s163555/sensor_pcb/README.md

# Sensor\_AFE\_PCB

* [PCB source](https://github.com/adafruit/Adafruit-MAX31865-PCB)
* [Wiki](https://learn.adafruit.com/adafruit-max31865-rtd-pt100-amplifier)
