s163555/sensor_pcb/Figure_2.png

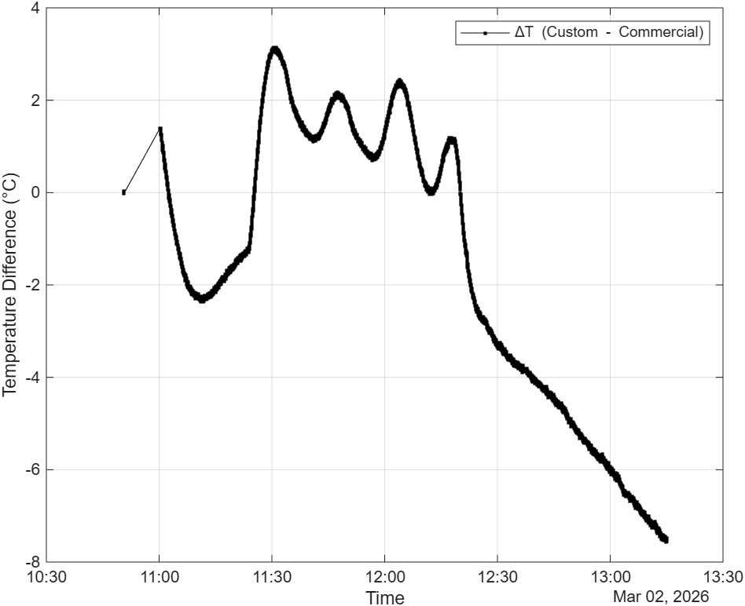
Figure_2.png
