s163555/sensor_pcb/wire_bond_holder2.stl

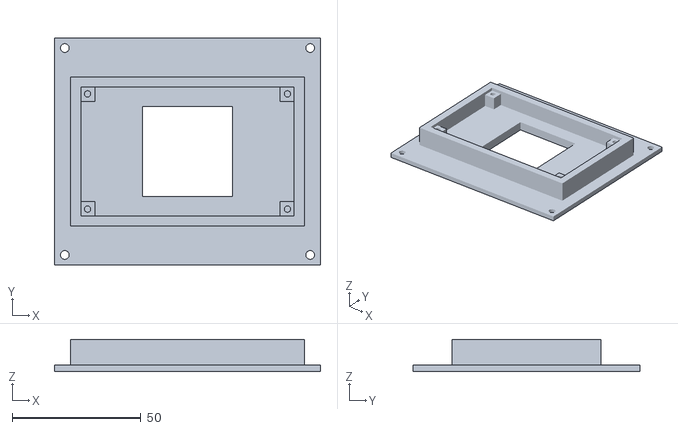
[picture p9: CAD file, 2026-03-02]
wire_bond_holder2.stl
103.5 x 88.5 x 12.5
