s163555/sensor_pcb/sensor_pcb.kicad_pcb

## KiCad design sensor_pcb.kicad_pcb (2025-10-31)

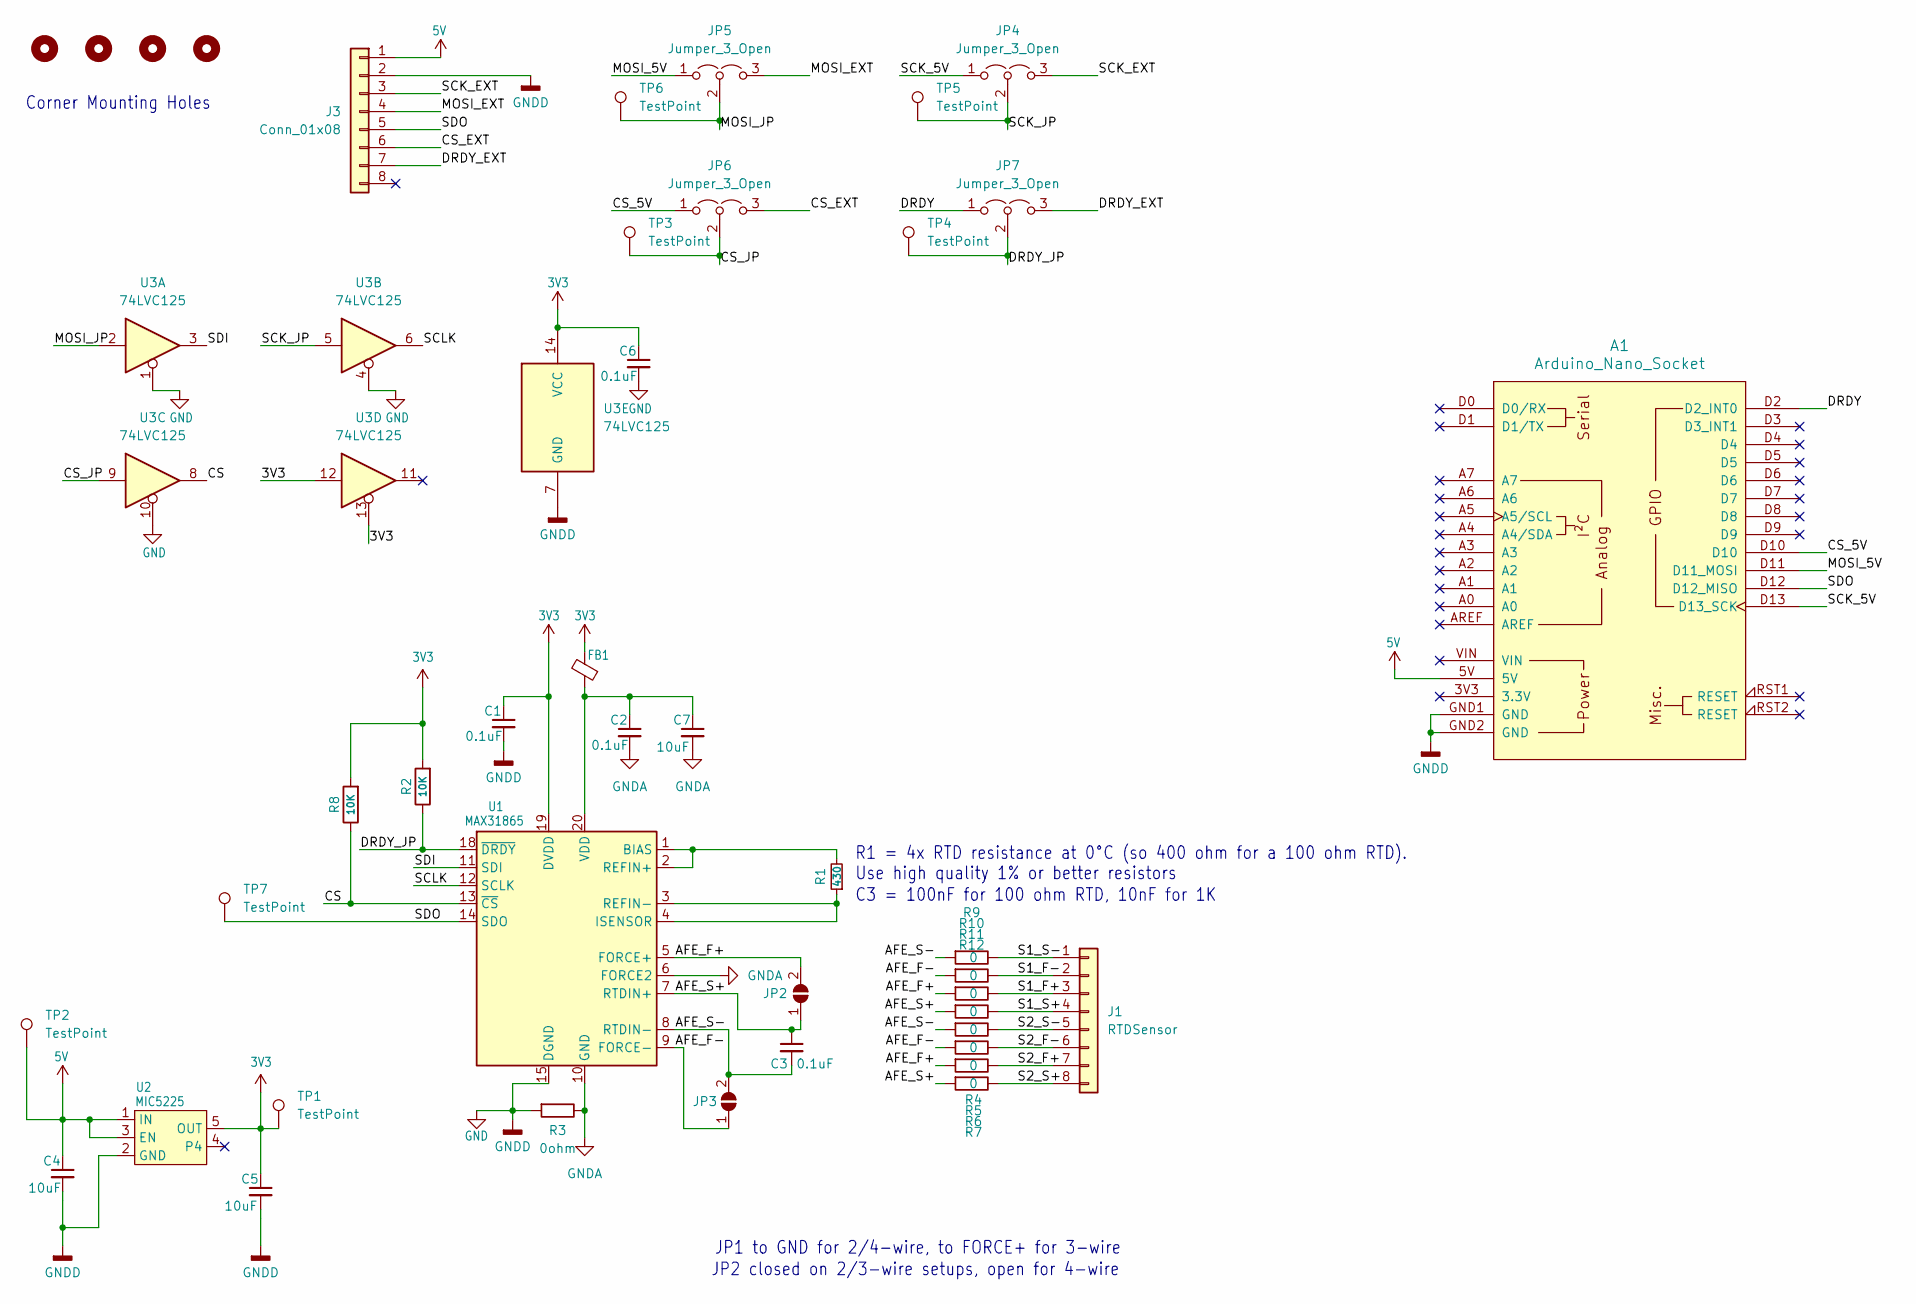
[picture p10: schematic sensor_pcb.kicad_sch, RTD Sensor PCB]

Parts:
A1: Arduino_Nano_Socket
C1, C2, C3, C6: 0.1uF; C_0805_2012Metric; MPN /
C4, C5, C7: 10uF; C_0805_2012Metric; MPN /
FB1: FERRITE-0805NO; LI0805G201R-10; MPN LI0805G201R-10
J1: RTDSensor; RTD_Sensor_BondPad_interdigitated
J3: Conn_01x08; Molex_KK-254_AE-6410-08A_1x08_P2.54mm_Vertical
JP2, JP3: SOLDERJUMPER; SolderJumper-2_P1.3mm_Open_RoundedPad1.0x1.5mm
JP4, JP5, JP6, JP7: Jumper_3_Open; PinHeader_1x03_P2.54mm_Vertical
R1: 430; R_0805_2012Metric; Tolerance Plus-Minus 0.1%; MPN /
R2, R8: 10K; R_0805_2012Metric; MPN /
R3: 0ohm; R_0805_2012Metric
R4, R5, R6, R7, R9, R10, R11, R12: 0; R_0805_2012Metric
TP1, TP2, TP3, TP4, TP5, TP6, TP7: TestPoint; TestPoint_Pad_D1.0mm
U1: MAX31865; MAX31865ATP+; MPN MAX31865ATP+
U2: MIC5225; MPN MIC5225-3.3YM5-TR
U3: 74LVC125
U$1, U$2, U$18, U$19: MOUNTINGHOLE2.5; MountingHole_2.2mm_M2_ISO7380

Connections:
3V3: C1.1, C5.1, C6.1, FB1.2, R2.2, R8.2, TP1.1, U1.19 (DVDD), U2.5 (OUT), U3.12, U3.13, U3.14 (VCC)
5V: A1.5V, C4.1, J3.1, TP2.1, U2.1 (IN), U2.3 (EN)
/AFE_F+: JP2.2 (B), R6.1, R11.1, U1.5 (FORCE+)
/AFE_F-: JP3.1 (A), R5.1, R10.1, U1.9 (FORCE-)
/AFE_S+: C3.1, JP2.1 (A), R7.1, R12.1, U1.7 (RTDIN+)
/AFE_S-: C3.2, JP3.2 (B), R4.1, R9.1, U1.8 (RTDIN-)
/CS: R8.1, U1.13 (~CS), U3.8
/CS_5V: A1.D10, JP6.1 (A)
/CS_EXT: J3.6, JP6.3 (B)
/CS_JP: JP6.2 (C), TP3.1, U3.9
/DRDY: A1.D2 (D2_INT0), JP7.1 (A)
/DRDY_EXT: J3.7, JP7.3 (B)
/DRDY_JP: JP7.2 (C), R2.1, TP4.1, U1.18 (~DRDY)
/MOSI_5V: A1.D11 (D11_MOSI), JP5.1 (A)
/MOSI_EXT: J3.4, JP5.3 (B)
/MOSI_JP: JP5.2 (C), TP6.1, U3.2
/S1_F+: J1.3, R11.2
/S1_F-: J1.2, R10.2
/S1_S+: J1.4, R12.2
/S1_S-: J1.1, R9.2
/S2_F+: J1.7, R6.2
/S2_F-: J1.6, R5.2
/S2_S+: J1.8, R7.2
/S2_S-: J1.5, R4.2
/SCK_5V: A1.D13 (D13_SCK), JP4.1 (A)
/SCK_EXT: J3.3, JP4.3 (B)
/SCK_JP: JP4.2 (C), TP5.1, U3.5
/SCLK: U1.12 (SCLK), U3.6
/SDI: U1.11 (SDI), U3.3
/SDO: A1.D12 (D12_MISO), J3.5, TP7.1, U1.14 (SDO)
GND: A1.GND1 (GND), A1.GND2 (GND), C1.2, C4.2, C5.2, C6.2, J3.2, R3.1, U1.15 (DGND), U2.2 (GND), U3.1, U3.4, U3.7 (GND), U3.10
GNDA: C2.2, C7.2, R3.2, U1.6 (FORCE2), U1.10 (GND), U1.16 (GND), U1.21 (GND)
unnamed: R1.2, U1.1 (BIAS), U1.2 (REFIN+)
unnamed: R1.1, U1.3 (REFIN-), U1.4 (ISENSOR)
unnamed: C2.1, C7.1, FB1.1, U1.20 (VDD)

Notes on the sheet:
JP1 to GND for 2/4-wire, to FORCE+ for 3-wire
R1 = 4x RTD resistance at 0°C (so 400 ohm for a 100 ohm RTD). Use high quality 1% or better resistors
Corner Mounting Holes
C3 = 100nF for 100 ohm RTD, 10nF for 1K
JP2 closed on 2/3-wire setups, open for 4-wire

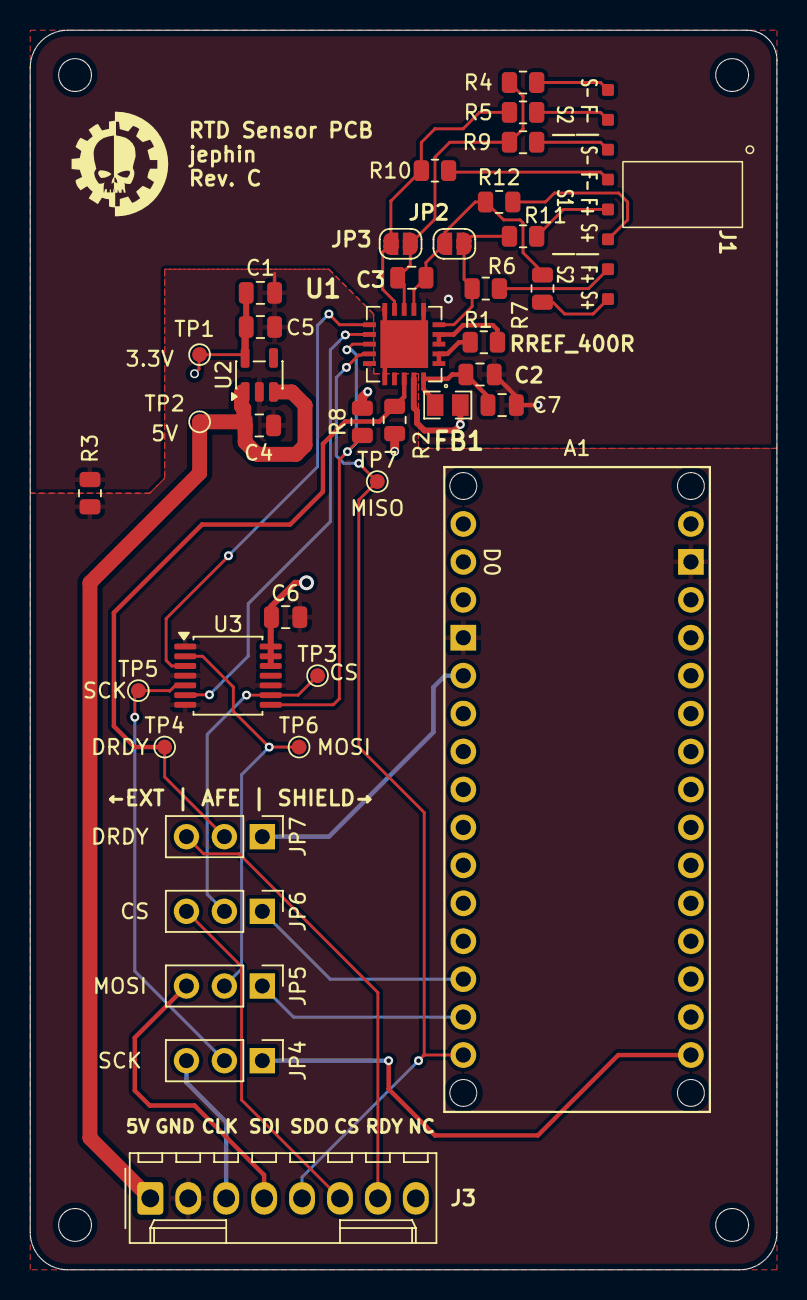
[picture p11: board sensor_pcb.kicad_pcb from above]

Board: 2 copper layers, 50.0 x 83.0 mm, 43 parts (0 on the bottom side), 35 nets.
