s163555/sensor_pcb/(commit log)

2024-03-05 blank KiCad project
    [MAX31865.kicad_pcb, MAX31865.kicad_sch]
2024-03-05 Eagle import
    [MAX31865.kicad_pcb, MAX31865.kicad_sch]
2024-03-06 added drawing sheet
    [MAX31865.kicad_pcb, MAX31865.kicad_sch]
2024-03-12 updated all capacitors
    [MAX31865.kicad_sch]
2024-03-12 updated all resistors
    [MAX31865.kicad_sch]
2024-03-12 updated all vdd
    [MAX31865.kicad_sch]
2024-03-12 updated all gnd
    [MAX31865.kicad_sch]
2024-03-13 updated all diodes
    [MAX31865.kicad_sch]
2024-03-13 updated ferrite bead
    [MAX31865.kicad_sch]
2024-03-13 updated solder jumpers
    [MAX31865.kicad_sch]
2024-03-13 updated header
    [MAX31865.kicad_sch]
2024-03-15 updated max31865
    [MAX31865.kicad_sch]
2024-03-15 updated screw terminal
    [MAX31865.kicad_sch]
2024-03-15 updated vin libraries
    [MAX31865.kicad_sch]
2024-03-15 changed to own library
    [MAX31865.kicad_sch]
2024-03-26 changed all capacitor foorprints in schematic
    [MAX31865.kicad_sch]
2024-03-26 changed all capacitor footprints on pcb layout
    [MAX31865.kicad_pcb]
2024-03-26 changed all resistor footprints in schematic
    [MAX31865.kicad_sch]
2024-03-26 changed all diode footprints in schematic
    [MAX31865.kicad_sch]
2024-03-26 changed all diode footprints on pcb layout
    [MAX31865.kicad_pcb]
2024-03-26 changed all connectors footprints in schematic
    [MAX31865.kicad_sch]
2024-03-26 changed all connector footprints on pcb layout
    [MAX31865.kicad_pcb]
2024-03-26 changed connector pin 1x08 footprints in schematic
    [MAX31865.kicad_sch]
2024-03-26 changed connector pin 1x08 footprints on pcb layout
    [MAX31865.kicad_pcb]
2024-03-26 changed mounting hole footprint in schematic and pcb layout
    [MAX31865.kicad_pcb]
2024-03-26 changed solder footprint in schematic and pcb layout
    [MAX31865.kicad_pcb, MAX31865.kicad_sch]
2024-03-26 changed fiducial footprint in schematic and pcb layout
    [MAX31865.kicad_pcb]
2024-03-27 changed sot-23-5 footprint in schematic and pcb layout
    [MAX31865.kicad_pcb, MAX31865.kicad_sch]
2024-03-27 changed 3 way solde jumper footprint in schematic and pcb layout
    [MAX31865.kicad_pcb]
2024-03-27 added ferrite bead symbol and footprint in external library
2024-03-28 fixed routing + added BOM info
    [MAX31865.kicad_pcb, MAX31865.kicad_sch]
2024-03-28 removed imported library
    [MAX31865.kicad_pcb, MAX31865.kicad_sch]
2024-03-28 added missing 3D models
    [MAX31865.kicad_pcb]
2024-04-01 improved routing
    [MAX31865.kicad_pcb, MAX31865.kicad_sch]
2024-04-01 silkscreen update
    [MAX31865.kicad_pcb]
2024-04-03 changed copper finish + solder mask and silkscreen color update
    [MAX31865.kicad_pcb]
2024-04-05 dielectric color update
    [MAX31865.kicad_pcb]
2024-05-17 updated solder jumper
    [MAX31865.kicad_pcb, MAX31865.kicad_sch]
2024-05-17 fixed connection mistake
    [MAX31865.kicad_pcb, MAX31865.kicad_sch]
2024-05-17 schematic update
    [MAX31865.kicad_pcb, MAX31865.kicad_sch]
2024-05-21 implemented Eurocircuits design remarks
    [MAX31865.kicad_pcb, MAX31865.kicad_sch]
2024-06-10 BOM presets update
    [MAX31865.kicad_pcb, MAX31865.kicad_sch]
2025-10-08 Added Nano shield to schematic
    [MAX31865.kicad_pcb, MAX31865.kicad_sch]
2025-10-10 Updated AFE with Arduino shield
    [MAX31865.kicad_pcb, MAX31865.kicad_sch]
2025-10-13 Updated layout
    [MAX31865.kicad_pcb]
2025-10-13 Added stp for ferrite 0805
    [LI0805G201R-10.step, MAX31865.kicad_pcb]
2025-10-13 Silkscreen on footprint
    [MAX31865.kicad_pcb]
2025-10-13 Added fab outputs
    [LI0805G201R-10.step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]
2025-10-13 Updated layout constraints
    [MAX31865.kicad_pcb]
2025-10-13 Layout update
    [MAX31865.kicad_pcb]
2025-10-13 Updated sensor footprint
    [MAX31865.kicad_pcb, MAX31865.kicad_sch]
2025-10-14 cicd trigger test
    [MAX31865.kicad_pcb]
2025-10-16 planed supply rails
    [MAX31865.kicad_pcb, MAX31865.kicad_sch]
2025-10-17 Cleaned up footprint library
    [LI0805G201R-10.step, MAX31865.kicad_pcb, MAX31865.kicad_sch]
2025-10-17 trigger cicd
    [MAX31865.kicad_pcb]
2025-10-17 collected external syms and footprints
    [MAX31865.kicad_pcb, MAX31865.kicad_sch]
2025-10-17 ci external cleanup
    [MAX31865.kicad_pcb, MAX31865.kicad_sch]
2025-10-17 fabrication outputs layout pdf
    [MAX31865.kicad_pcb, MAX31865.kicad_sch]
2025-10-17 CI trigger
    [MAX31865.kicad_pcb]
2025-10-17 gerbers included in outputs
2025-10-17 CI clean artifact
    [MAX31865.kicad_pcb]
2025-10-17 CI removed duplicate gerbers
    [MAX31865.kicad_pcb]
2025-10-17 changed project file names
    [sensor_pcb.kicad_pcb, sensor_pcb.kicad_sch]
2025-10-17 release ready
    [sensor_pcb.kicad_pcb]
2025-10-17 removed fabrication outputs from revision control
    [MAX31865-B_Cu.gbr, MAX31865-B_Fab.gbr, MAX31865-B_Mask.gbr, MAX31865-B_Paste.gbr, MAX31865-B_Silkscreen.gbr, MAX31865-Edge_Cuts.gbr, MAX31865-F_Cu.gbr, MAX31865-F_Fab.gbr]
2025-10-17 Added fabrication folder to gitignore
    [sensor_pcb.kicad_pcb]
2025-10-17 fabrication outputs from kibot rather than repo
    [sensor_pcb.kicad_pcb]
2025-10-17 added more debug info
    [sensor_pcb.kicad_sch]
2025-10-17 just work
    [sensor_pcb.kicad_pcb]
2025-10-20 Added missing SPN info to parts
    [sensor_pcb.kicad_pcb, sensor_pcb.kicad_sch]
2025-10-30 RTD sensor wire bonding landing pattern interdigitated
    [sensor_pcb.kicad_pcb, sensor_pcb.kicad_sch]
2025-10-30 Updated GND/GNDA planes
    [sensor_pcb.kicad_pcb]
2025-10-31 Revision C of layout
    [sensor_pcb.kicad_pcb, sensor_pcb.kicad_sch]
2025-11-21 Added MCU firmware for rtd sensor
2025-11-21 extra decimal on temperature readout
2025-12-12 Added fault information to firmware. Added PCB holder 3D model for wire-bonding
    [wire_bond_holder.scad]
2025-12-16 added base plate for mounting to tpt100 chuck
    [wire_bond_holder.scad]
2025-12-17 fixed pcb holder for wire bonder
    [wire_bond_holder2.scad]
2025-12-17 reinforced pcb standoffs to sidewall
    [wire_bond_holder2.scad]
2025-12-17 added window to base of pcb holder
    [wire_bond_holder2.scad]
2026-03-02 added measurement data
    [wire_bond_holder2.stl, wire_bond_holder3.stl]
2026-03-10 added plots, resistance vs temperature plot
